bellTanTan/Esp32PC8001SIO/img/036.jpg

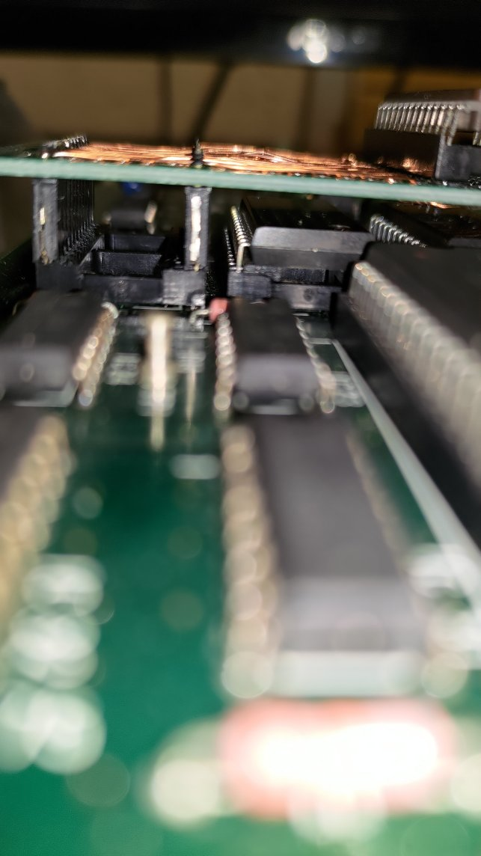
img/036.jpg
