bellTanTan/Esp32PC8001SIO/(commit log)

2022-08-09 BME280計測秒配列オーバー対策
    閏(うるう)秒挿入時にBME280計測秒配列オーバーが予測されるための改定
2022-09-18 Arduino ESP32 v2.0.5 確認
    Arduino ESP32 v2.0.5 確認OK
2022-10-06 v1.0.1
    spiffs関連機能実装。PC-8001mkII(N80モード/Nモード)対応。PC-8001mkIIRS-232C受信割込実装。DLにてEA00HorE600Hに入り込むメモリオーバー判定と受信不良の改修
2022-10-23 v1.0.2
    バイナリ受信系不良改修
    多段ロード形式対応
2023-04-16 v1.0.3
    cmd sntp or mat sntp で月が正しく定義出来ない不具合改修
